IssacDRoss/Shuttle_Visual_Servoing/README.md

# Shuttle_Visual_Servoing
Visual Servoing Independent Stufy
