IssacDRoss/Shuttle_Visual_Servoing/Python Scripts/shuttle.png

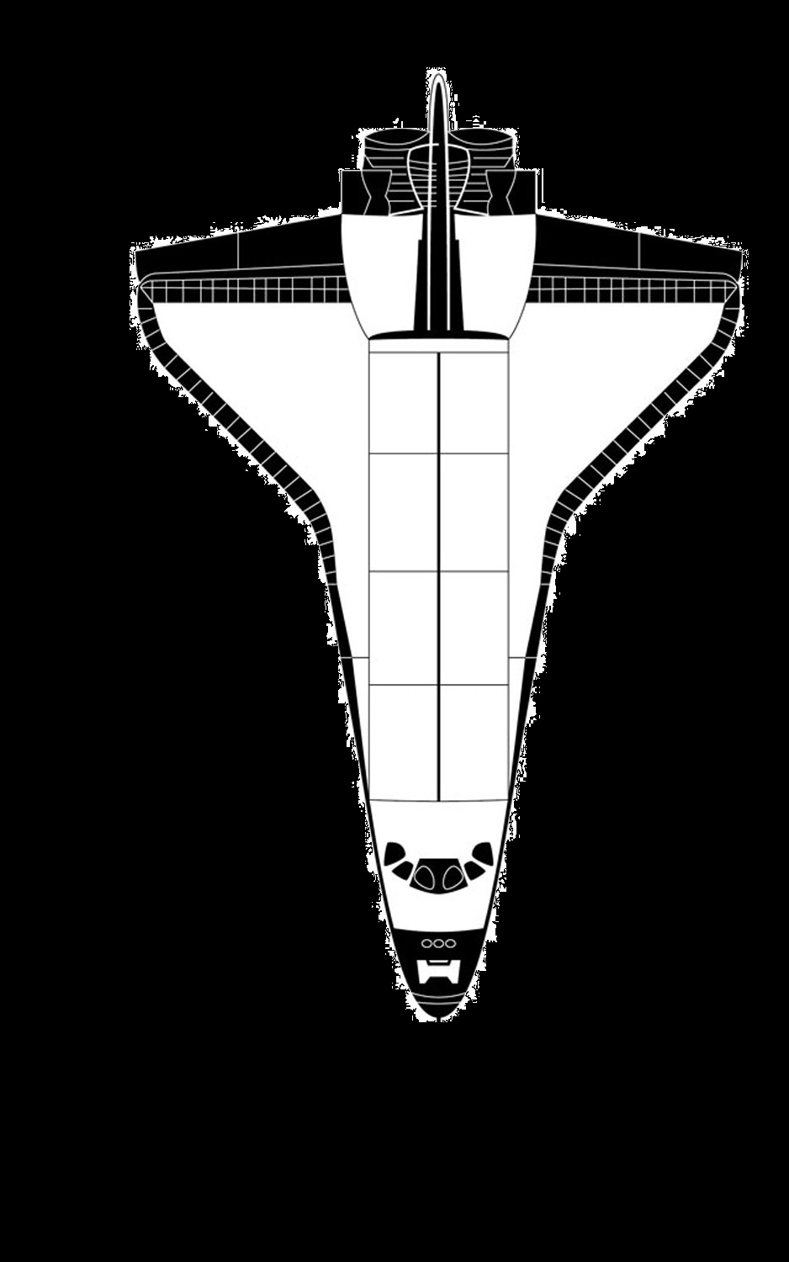
Python Scripts/shuttle.png
