IssacDRoss/Shuttle_Visual_Servoing/CAD_Model/Shuttle.SLDASM

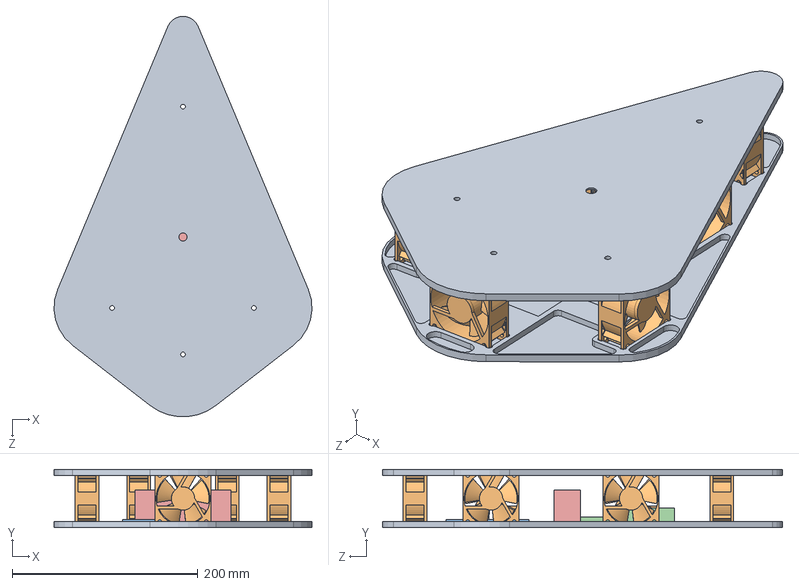
[picture p26: CAD file, 2026-01-02]
CAD_Model/Shuttle.SLDASM
277.6 x 62.5 x 430.5 mm
Baseplate x 2
1939K580_DC EQUIPMENT COOLING FAN x 6
Xbee_circuit
Arduino_mega
11V_BatteryPack
