IssacDRoss/Shuttle_Visual_Servoing/CAD_Model/Baseplate.SLDPRT

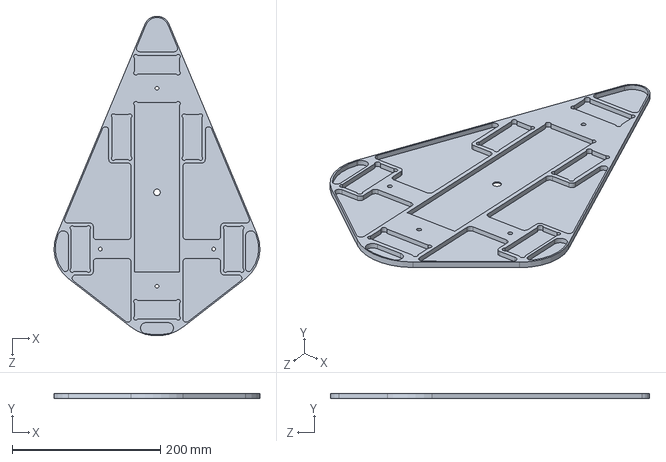
[picture p27: CAD file, 2026-01-02]
CAD_Model/Baseplate.SLDPRT
277.6 x 6.35 x 430.5 mm
