IssacDRoss/Shuttle_Visual_Servoing/CAD_Model/Arduino_mega.SLDPRT

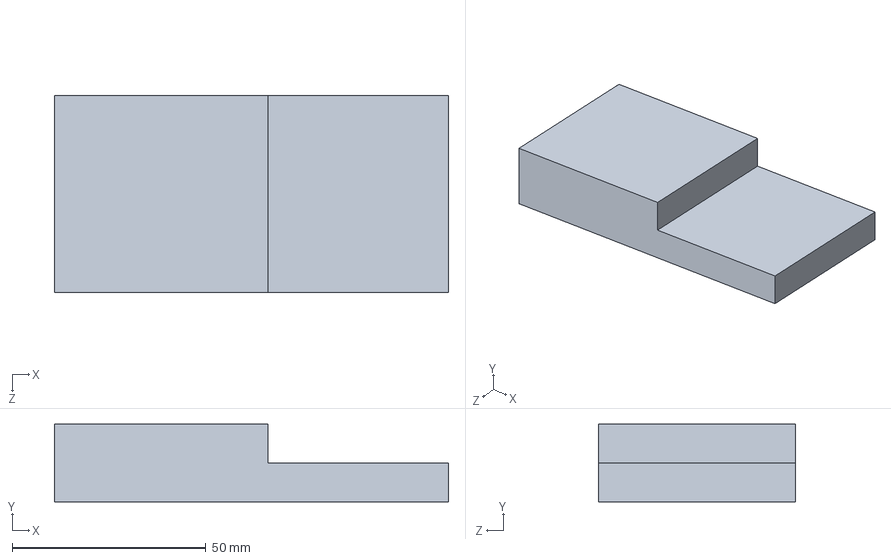
[picture p28: CAD file, 2026-01-02]
CAD_Model/Arduino_mega.SLDPRT
101.6 x 20.0 x 50.8 mm
