IssacDRoss/Shuttle_Visual_Servoing/CAD_Model/11V_BatteryPack.SLDPRT

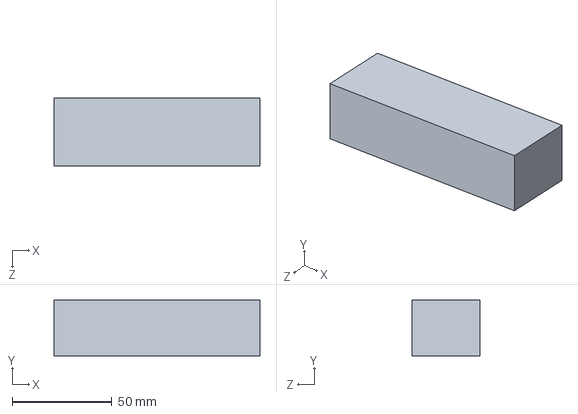
[picture p29: CAD file, 2026-01-02]
CAD_Model/11V_BatteryPack.SLDPRT
103.0 x 28.0 x 34.0 mm
