IssacDRoss/Shuttle_Visual_Servoing/CAD_Model/Xbee_circuit.SLDPRT

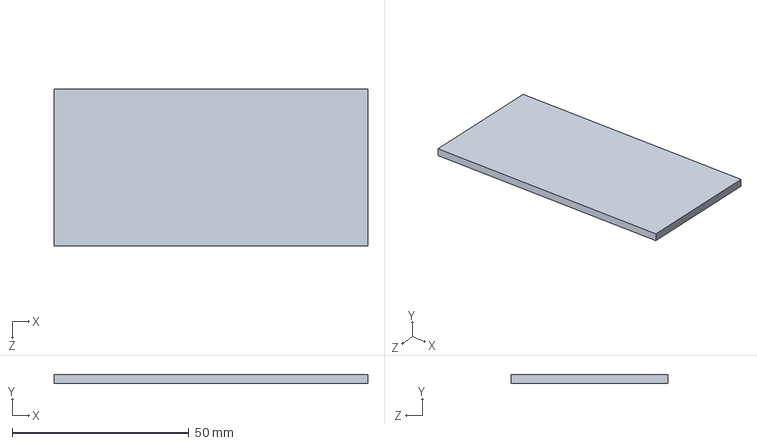
[picture p30: CAD file, 2026-01-02]
CAD_Model/Xbee_circuit.SLDPRT
88.9 x 2.54 x 44.5 mm
