IssacDRoss/Shuttle_Visual_Servoing/CAD_Model/1939K580_DC EQUIPMENT COOLING FAN.SLDPRT

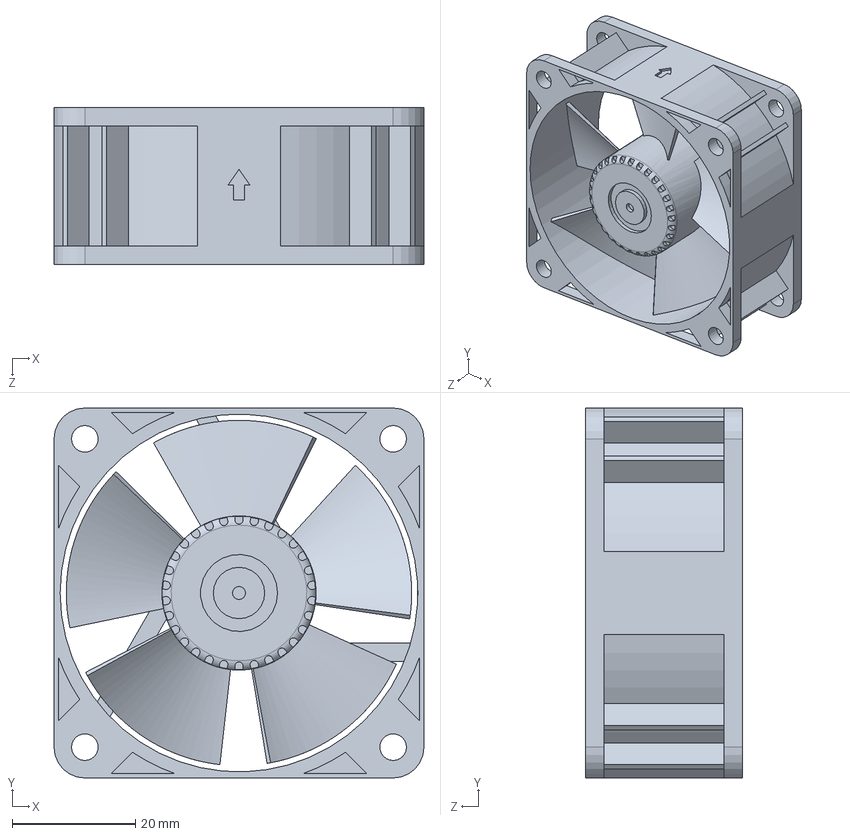
[picture p31: CAD file, 2026-01-02]
CAD_Model/1939K580_DC EQUIPMENT COOLING FAN.SLDPRT
60.0 x 60.0 x 25.4 mm
